3d-paws/3D-PAWS-WatchDog/KiCad - WatchDog -V4 Board/WatchDogV4-Assembled.png

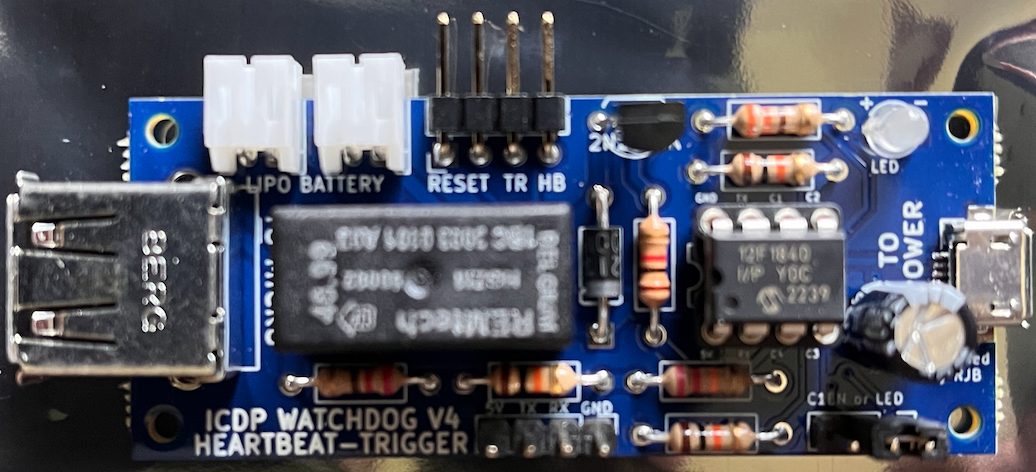
KiCad - WatchDog -V4 Board/WatchDogV4-Assembled.png
