3d-paws/3D-PAWS-WatchDog/OpenSCAD - Enclousure/WatchDogBox.stl

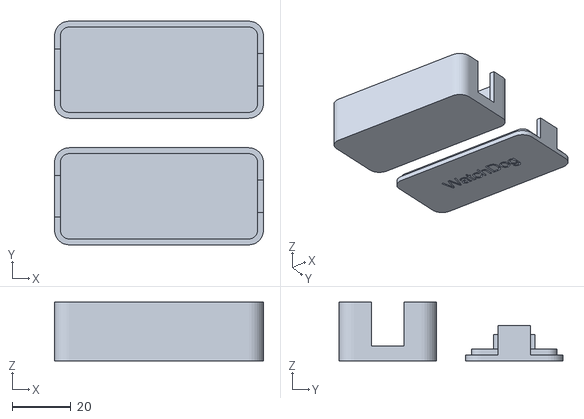
[picture p11: CAD file, 2025-05-28]
OpenSCAD - Enclousure/WatchDogBox.stl
71.0 x 76.0 x 20.0
