3d-paws/3D-PAWS-WatchDog/KiCad - WatchDog -V4 Board/WatchDogV4.kicad_pcb

## KiCad design KiCad - WatchDog -V4 Board/WatchDogV4.kicad_pcb (2024-07-15)

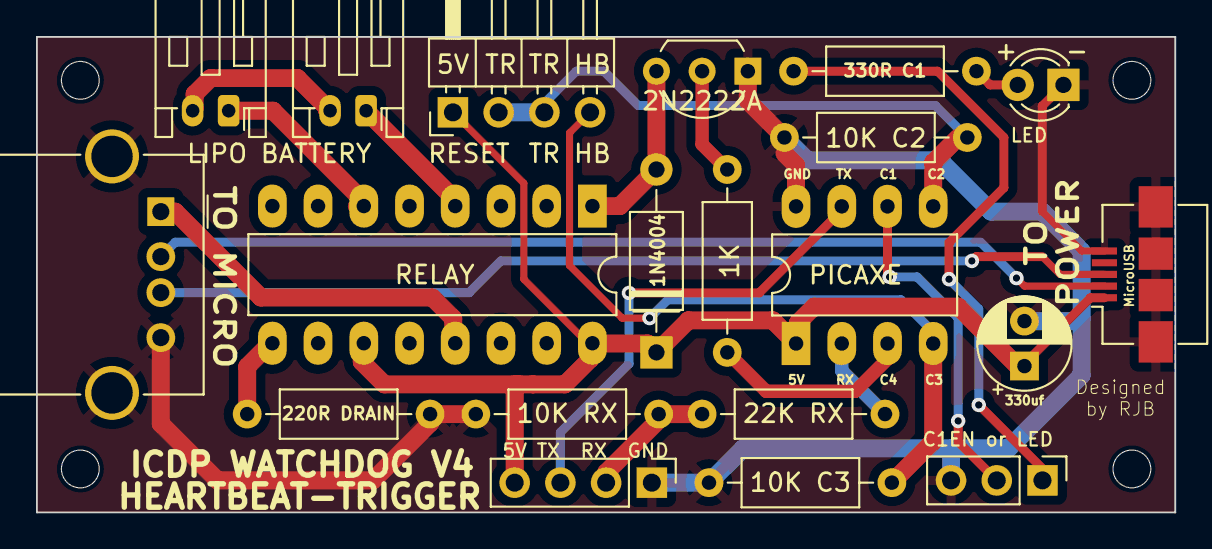
[picture p12: board WatchDogV4.kicad_pcb from above]

Board: 2 copper layers, 63.2 x 26.4 mm, 21 parts (0 on the bottom side), 9 nets.

Parts:
1K, 10K C2, 10K C3, 10K RX, 22K RX, 220R DRAIN, 330R C1: R_Axial_DIN0207_L6.3mm_D2.5mm_P10.16mm_Horizontal
1N4004: D_A-405_P10.16mm_Horizontal
2N2222A: TO-92L_Inline_Wide
330uf: CP_Radial_D5.0mm_P2.50mm
BAT IN: JST_PH_S2B-PH-K_1x02_P2.00mm_Horizontal
BAT-OUT: JST_PH_S2B-PH-K_1x02_P2.00mm_Horizontal
BLH: MountingHole_2.1mm
BRH: MountingHole_2.1mm
LED: LED_D3.0mm
MicroUSB: USB_Micro-B_Amphenol_10104110_Horizontal
PICAXE: DIP-8_W7.62mm_LongPads
RELAY: DIP-16_W7.62mm_LongPads
TLH: MountingHole_2.1mm
TO MICRO: USB_A_Molex_67643_Horizontal
TRH: MountingHole_2.1mm

Connections:
5V: 1N4004.1, 330uf.1, MicroUSB.1, PICAXE.1, RELAY.11, RELAY.16
Base: 1K.2, 2N2222A.2
Collector: 1N4004.2, 2N2222A.3, RELAY.1
D+: MicroUSB.3, TO MICRO.3
D-: MicroUSB.2, TO MICRO.2
GND: 2N2222A.1, 10K C2.1, 10K C3.1, 10K RX.1, 220R DRAIN.1, 330uf.2, LED.1, MicroUSB.5, MicroUSB.6, PICAXE.8, TO MICRO.4, TO MICRO.5
HB: 10K C3.2, PICAXE.4
RX: 10K RX.2, 22K RX.1
TR: 10K C2.2, PICAXE.5, RELAY.4
